ChrisAlthaus/bachelor-thesis/scenarioHandler/README.md

# ScenarioHandler
ScenarioHandler for Raspberry Pi to controll the MovingBar
