ChrisAlthaus/bachelor-thesis/models/mounting_enclosure.stl

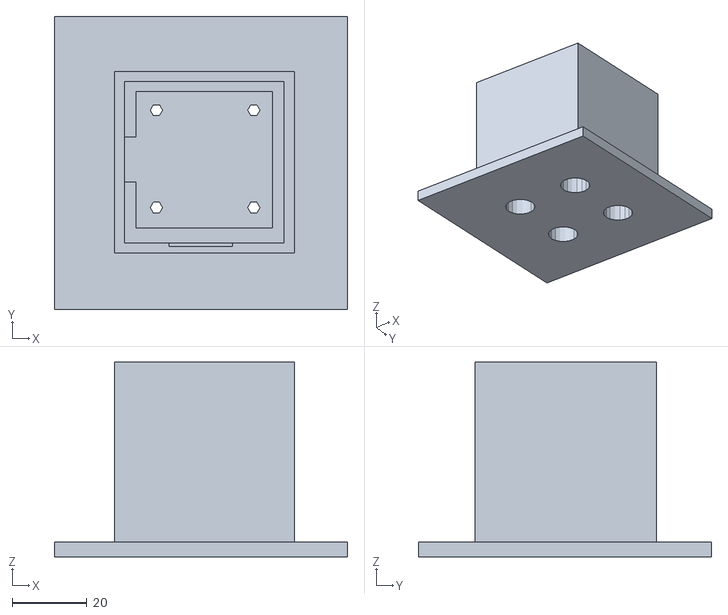
[picture p56: CAD file, 2018-01-30]
models/mounting_enclosure.stl
78.2 x 78.2 x 52.0
