ChrisAlthaus/bachelor-thesis/models/controller_top.stl

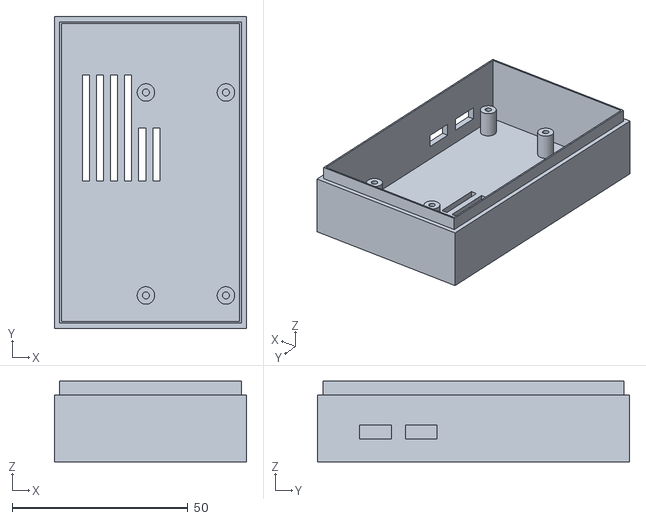
[picture p57: CAD file, 2018-01-30]
models/controller_top.stl
54.7 x 88.7 x 23.0
