ChrisAlthaus/bachelor-thesis/models/controller_bottom.stl

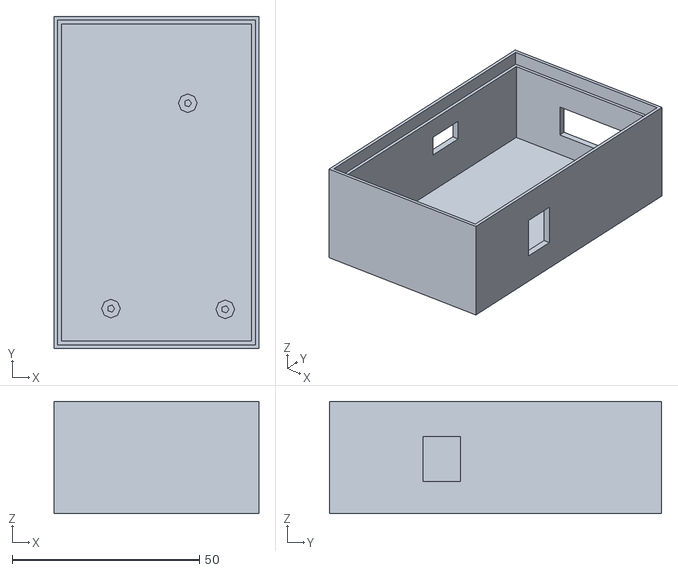
[picture p58: CAD file, 2018-01-30]
models/controller_bottom.stl
54.7 x 88.7 x 30.0
