ChrisAlthaus/bachelor-thesis/motor_lighting_controller/Modes.h

#ifndef MODES_H
#define MODES_H
//message protocol

struct modes{
  byte MOVE;
  byte UP;
  byte DOWN;
  byte INIT;
  byte ANI;
  byte LIGHT;
  byte LEVEL;
  byte BRIGHTNESS;
};

modes MODE={1,2,3,4,5,6,7,8};

struct speeds{
  byte FULL;
  byte HALF;
  byte QUARTER;
  byte EIGTHTH;
};

speeds SPEED={1,2,3,4};

struct initShortcut{
  byte TOP;
  byte BOTTOM;
  byte CALIBRATE;
};

initShortcut INIT={1,2,3};

struct animationTypes{
	byte SINGLE;
	byte OVERALL;
};

animationTypes ANIMATIONTYPES={1,2};

struct animations{
  byte BLINK;
  byte BEACON;
  byte STAIRCASE;
  byte PULSESLOW;
  byte TRANSMISSIONFB;
  
  byte ON;
  byte OFF;
  byte UP;
  byte DOWN;
  byte COM;
  byte BOUNCE;
  byte MOVE;
  byte GLOW;

};

animations ANIMATION={1,2,3,4,5,6,7,8,9,10,11,12,13};

struct sides{
  char A;
  char B;
  char C;
  char D;
};

sides SIDE={2,3,0,1};

struct lightOperations{
  char ADD;
  char REMOVE;
  char CLEARSIDE;
};

lightOperations LIGHTOPERATIONS={1,2,3};


#endif
