ChrisAlthaus/bachelor-thesis/(commit log)

2017-12-01 added eagle files
    [miniArduino.brd, miniArduino.sch]
2017-12-01 Add workspace files
    [country_id's.csv, miniArduino.brd, miniArduino.sch]
2017-12-12 eagle files uploaded
    [scd_v2.brd, scd_v2.sch]
2017-12-12 deleted files
    [miniArduino.brd, miniArduino.sch]
2018-01-30 uploaded model files
    [controller_bottom.scad, controller_bottom.stl, controller_top.scad, controller_top.stl, mounting_enclosure.scad, mounting_enclosure.stl]
